onurmetueee/ee463-Hardware/non-ideal simulation test results/pwm voltage of the controller.png

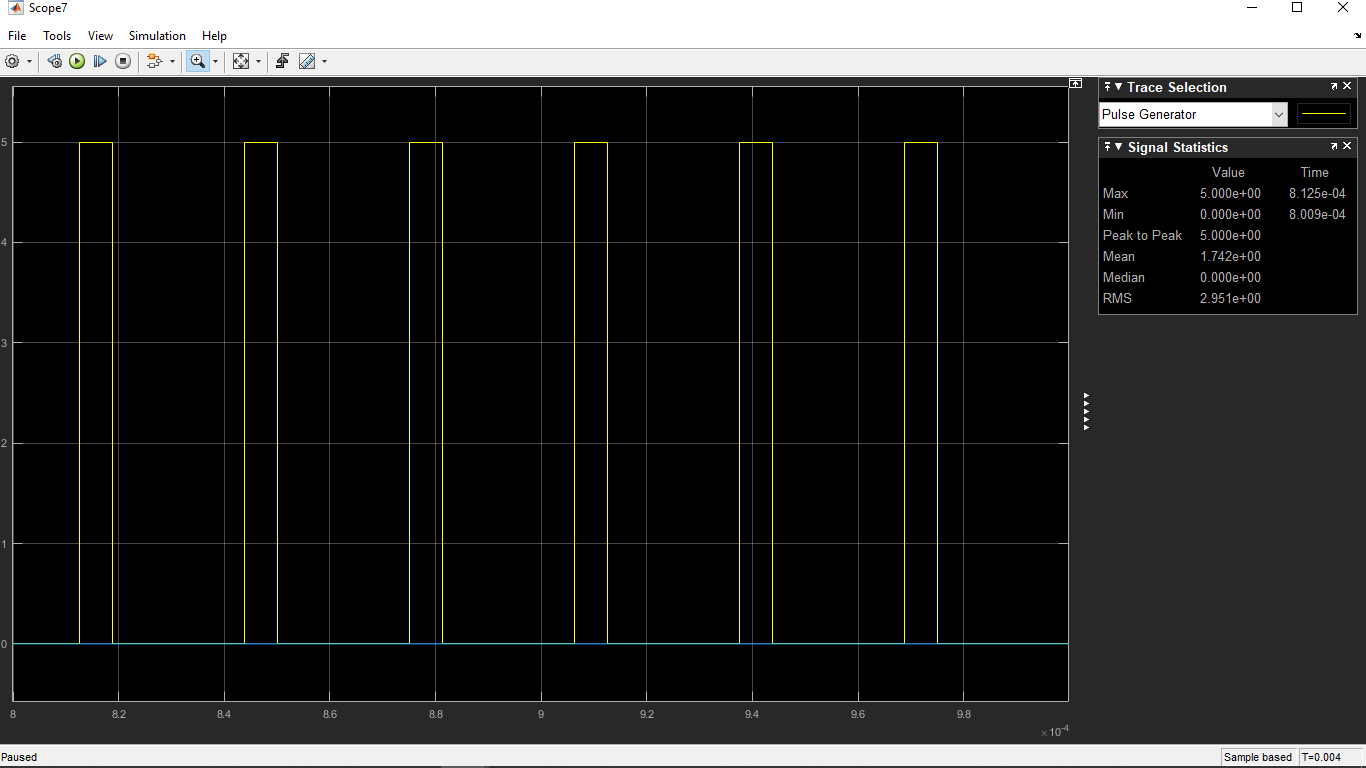
non-ideal simulation test results/pwm voltage of the controller.png
