onurmetueee/ee463-Hardware/non-ideal simulation test results/transformer primary(above) and secondary(below) voltage waveforms.png

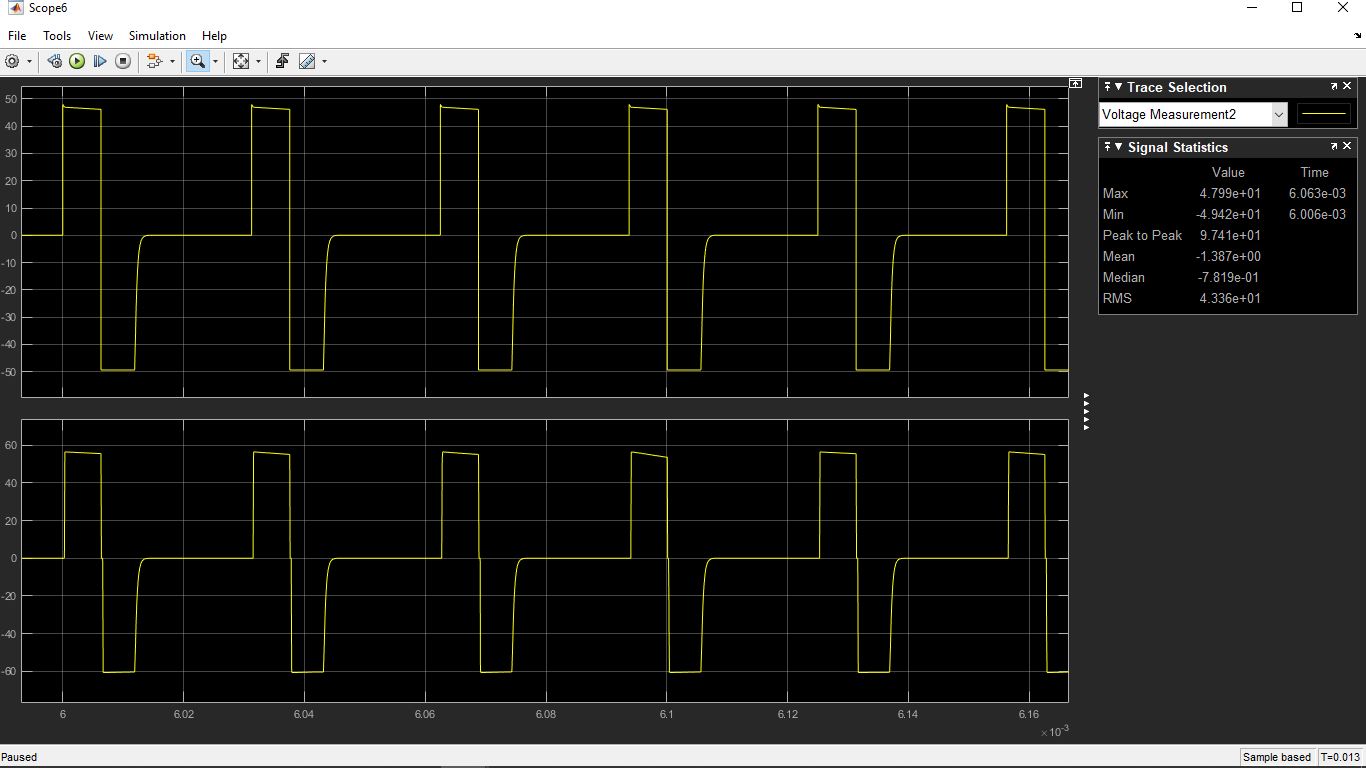
non-ideal simulation test results/transformer primary(above) and secondary(below) voltage waveforms.png
