onurmetueee/ee463-Hardware/(commit log)

2019-05-19 Circuit of the forward converter
2019-05-20 Circuit of the converter
2019-05-20 simple feedback code for arduino nano w/o controller
2019-06-03 arduino code that we are using
